p1ne/fdim-controller/doc/images/fdim_connector_stock.jpg

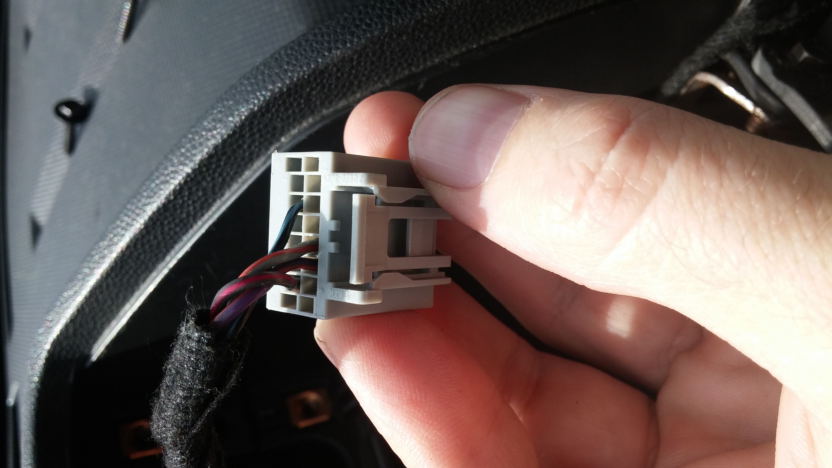
doc/images/fdim_connector_stock.jpg
