p1ne/fdim-controller/doc/images/fdim_rear.jpg

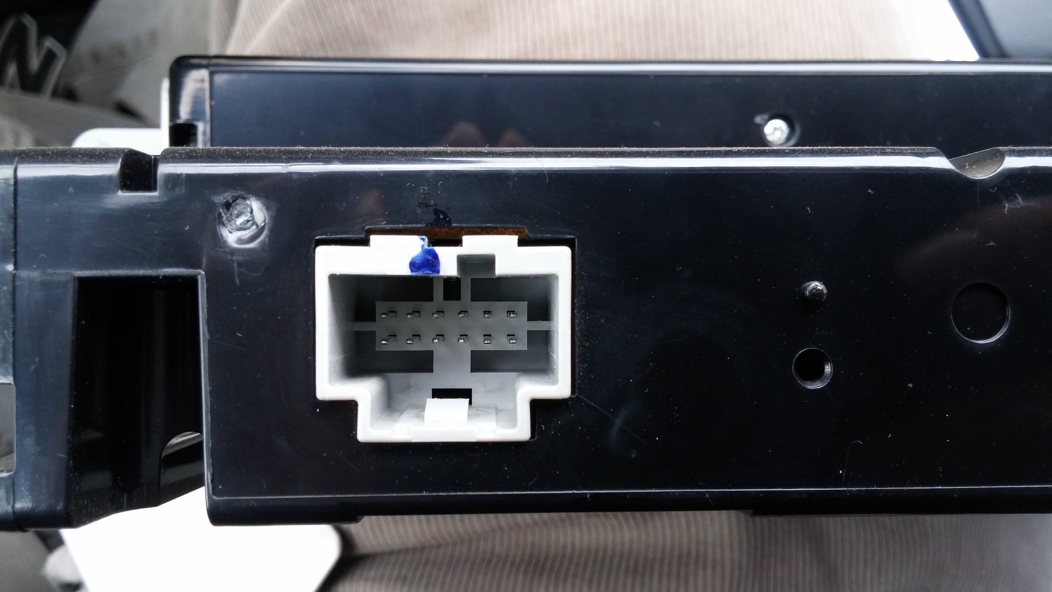
doc/images/fdim_rear.jpg
