p1ne/fdim-controller/doc/images/hu_aftermarket_can.jpg

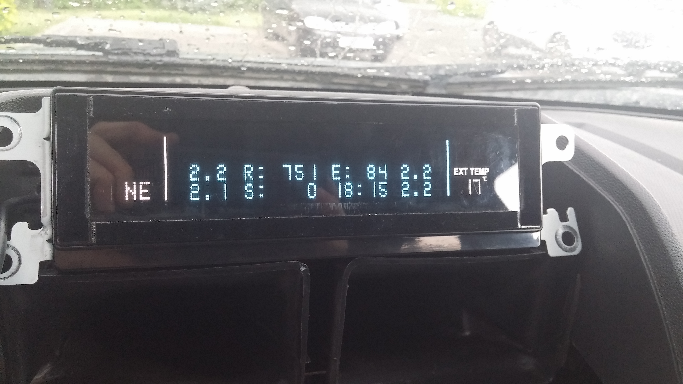
doc/images/hu_aftermarket_can.jpg
