p1ne/fdim-controller/doc/images/hu_minimal.jpg

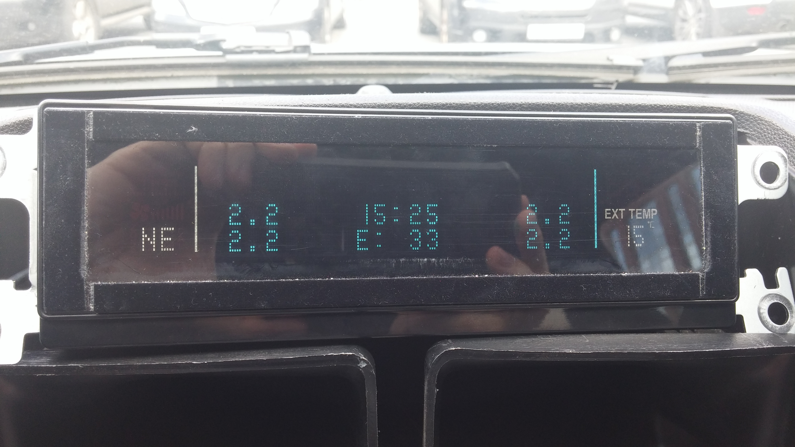
doc/images/hu_minimal.jpg
