p1ne/fdim-controller/doc/images/hu_stock.jpg

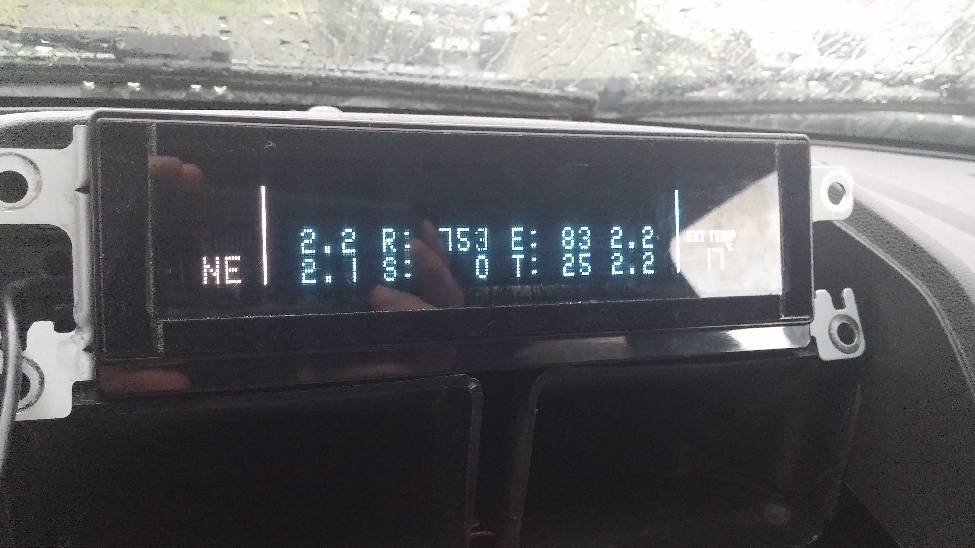
doc/images/hu_stock.jpg
