p1ne/fdim-controller/doc/images/module_elm.jpg

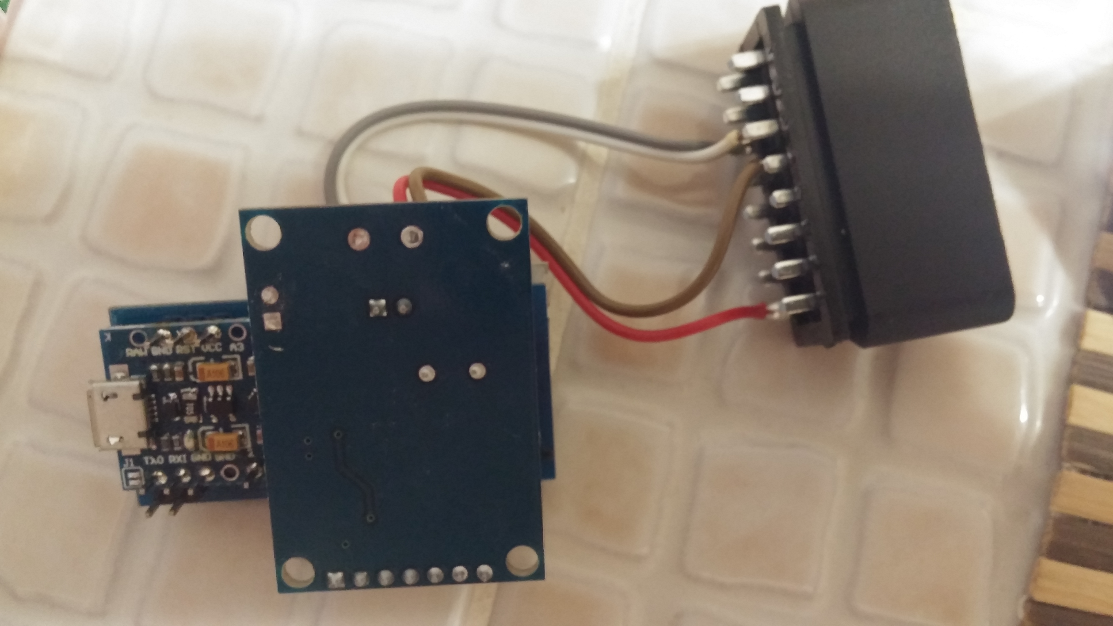
doc/images/module_elm.jpg
