p1ne/fdim-controller/doc/images/options_kpa.jpg

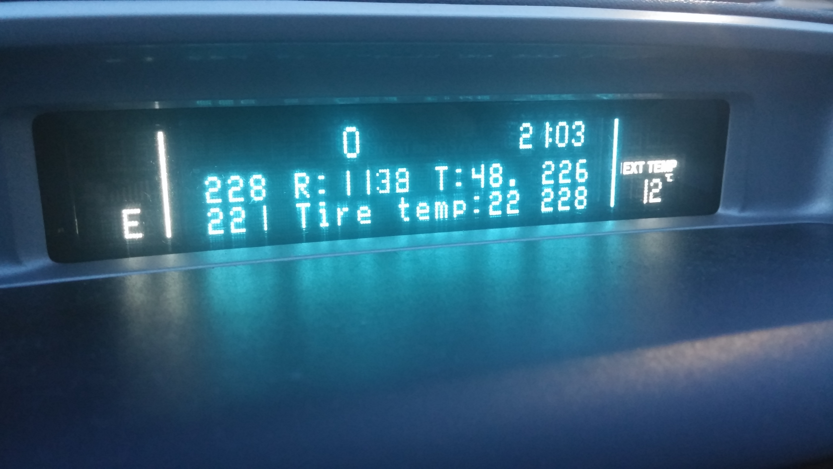
doc/images/options_kpa.jpg
