p1ne/fdim-controller/doc/images/rtc_replaced_battery.jpg

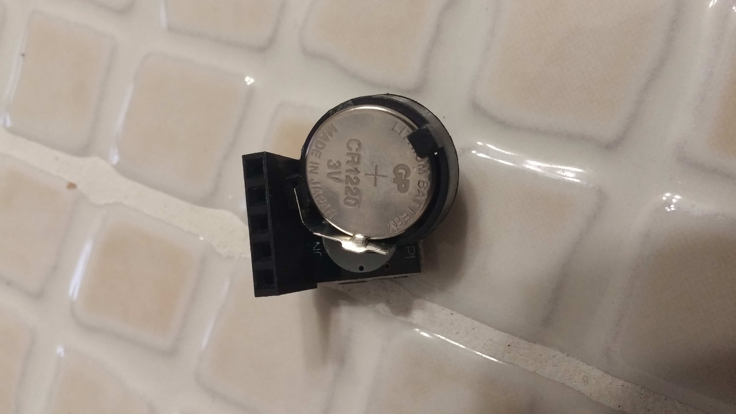
doc/images/rtc_replaced_battery.jpg
