p1ne/fdim-controller/doc/zadig/zadig6.png

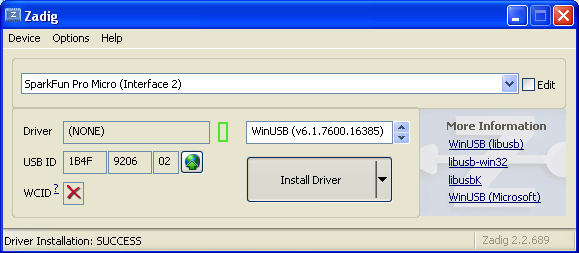
doc/zadig/zadig6.png
