p1ne/fdim-controller/doc/images/components/pin-strips-2x6.jpg

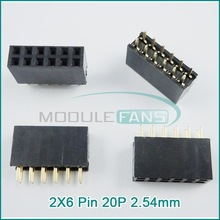
doc/images/components/pin-strips-2x6.jpg
