p1ne/fdim-controller/doc/images/fdim_connector_wiring.jpg

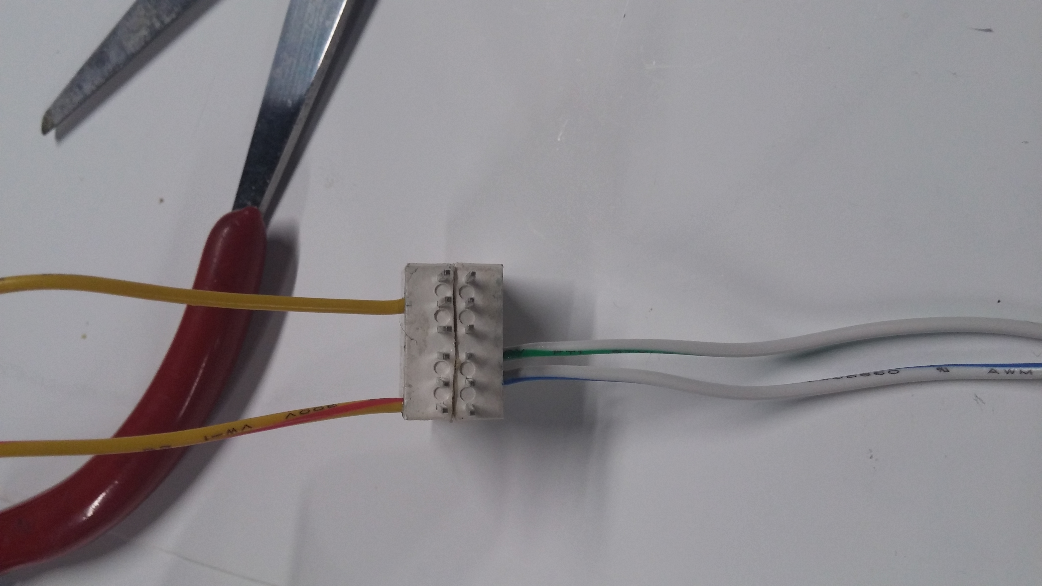
doc/images/fdim_connector_wiring.jpg
