p1ne/fdim-controller/doc/images/history_modules_generations.jpg

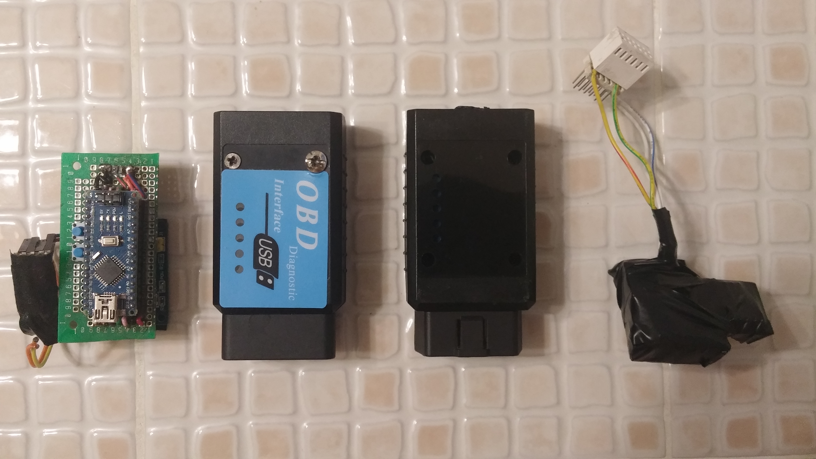
doc/images/history_modules_generations.jpg
