p1ne/fdim-controller/(threads)

Thread 2 (2019-04-27):

Clock 12 Hr setting issues

itbland, 2019-04-27:
When the clock is set to 12 Hr mode, there is one problem and one setting missing:

1. In 12 hr mode the % calculation results in a zero for the first hour and 12th hour of the day.
Possible solution: just after line 390, would an if statement something like:
`if (hour == 0  && currentSettings.clockMode == CLOCK_12)
    hour = 12;`
be the fix since it would be a problem for both the RTC and GPS in 12 Hr mode.
2. In 12 hr mode, the clock's flags data byte sent should be updated to 0xA0 for AM, 0xC0 for PM

Thread 6 (2019-07-09):

Utilize MS-CAN for homebrew AUX/DVD input

fuxxociety, 2019-07-09:
Im doing some research, and stumbled upon your code.

I have a 2004 & 2005 Ford, so no message center, just a dumb radio. I'd like to configure two AUX inputs on my radio. (I have the factory DVD player, it has RCA inputs on the front panel and both DVD & RCA inputs are unique "inputs".

It looks like message header 0x3e8 is the magic packet I would need.

Can you suggest a howto or primer I could reference to get this functionality for my arduino?

Sorry for the bug report, I could find no other contact method.

Thread 8 (2020-02-10):

Tire display order

bmwhitetx, 2020-02-10:
In the case statement for setting up the display, The HU_STOCK and two HU_CHINESE's both have the rear tire pressures listed as RL first and RR second which makes sense and matches the front tire order defined in preceding line.

However the HU_AFTERMARKET has the order reversed: RR is listed on the left and RL is on on the right. (lines removed for readablilty)

          case HU_AFTERMARKET:
            displayText(1, tirePressure[TIRE_FL].padRight(pressurePadding) + rpmMessage + rpm.padRight(4) + F(" E:") + temperature.padRight(3) + " " + tirePressure[TIRE_FR].padRight(pressurePadding));
            displayText(2, tirePressure[TIRE_RR].padRight(pressurePadding) + tireTempMessage + tireTemperature.padRight(3) + " " + tirePressure[TIRE_RL].padRight(pressurePadding));

          case HU_STOCK:
            displayText(1, tirePressure[TIRE_FL].padRight(pressurePadding) + rpmMessage + rpm.padRight(4) + F(" E:") + temperature.padRight(3) + " " + tirePressure[TIRE_FR].padRight(pressurePadding));
            displayText(2, tirePressure[TIRE_RL].padRight(pressurePadding) + spdMessage + carSpeed.padRight(4) + F(" T:") + tireTemperature.padRight(3) + " " + tirePressure[TIRE_RR].padRight(pressurePadding));

          case HU_CHINESE_WITH_CAN_SIMPLE:
            displayText(1, tirePressure[TIRE_FL].padRight(pressurePadding) + clockMessage.padCenter(textMsgLength+2) + tirePressure[TIRE_FR].padRight(pressurePadding));
            displayText(2, tirePressure[TIRE_RL].padRight(pressurePadding) + temperatureMessage.padCenter(textMsgLength+2) + tirePressure[TIRE_RR].padRight(pressurePadding));

          case HU_CHINESE_WITH_CAN_EXTENDED:
            displayText(1, tirePressure[TIRE_FL].padRight(pressurePadding) + rpmMessage + rpm.padRight(4) + F(" E:") + temperature.padRight(3) + " " + tirePressure[TIRE_FR].padRight(pressurePadding));
            displayText(2, tirePressure[TIRE_RL].padRight(pressurePadding) + spdMessage + carSpeed.padRight(4) + F(" ") + clockMessage + F(" ") + tirePressure[TIRE_RR].padRight(pressurePadding));

Great work BTW, Just what I was looking for!
