p1ne/fdim-controller/(list of files, drawings)

Other design files:
pcb/diptrace/can-clock-17-09.dch
pcb/diptrace/can-clock-17-09.dip
