p1ne/fdim-controller/(commit log)

2016-01-30 Fixed delays in text CAN messages set
    [can-clock.ino]
2016-03-20 Numerous fixes, clean-up of timing constants
    [can-clock.ino]
2016-05-31 Turn off display (partly broken)
    [can-clock.ino]
2016-06-01 Massive refactor of message sending - bound to common timer now
2017-02-13 Moved CANMessage class to separate file Modified libraries search path in platformio.ini Added compile-time defines to properly set interrupts on 328/32u4 boards Datatypes cleanup (signed/unsigned, b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
2017-02-14 Experimental refactoring: moved all strings that need fomatting to FormattedString class Made cleanup of datatypes, cleanup for CANMessage::print() function
2017-02-14 Massively fix FormattedString.h to work properly
    [FormattedString.h, can-clock.ino]
2017-04-21 temp update for int pin number
2017-04-21 changed pin mode
2017-04-21 updated interrupt pin number for Nano
2017-04-21 Updated interrupt pin number for Arduino Pro Micro
2017-06-15 Added preliminary RTC support for pre-2010 vehicles. Separated CAN sequences to FordMessages.h Added defines to prevent multi-inclusion of *.h files
    [CANMessage.h, FordMessages.h, FormattedString.h, can-clock.ino]
2017-06-15 Added missing change for one-time settings run (see previous commit)
    [Settings.h]
2017-06-15 add wiring connections instruction
2017-06-15 Modified interrupt pin number for Nano
2017-06-15 Reverted back lost changes from experimental
    [can-clock.ino]
2017-06-15 Moved to forked CAN library with setting of CAN mode Updated code for proper setting of filters and masks Misc improvements and bug fixes
    [Settings.h, can-clock.ino]
2017-06-15 Added temperature rounding
2017-06-15 Added support for TPMS request-response protocol No support for tire temperature yet
2017-06-15 Moved pressure strings initialization to another place
2017-06-15 Modified way to parse pressure responses 0x72e
2017-06-15 if condition typo fix
    [can-clock.ino]
2017-06-15 Fixed TPMS fields indexes
    [can-clock.ino]
2017-06-15 Changed bars to kPa to display pressure
2017-06-15 Added tire temperature to requests loop
2017-06-15 Removed IS_HYBRID workaround, changed to 0x423 5th byte analysis Fixed typos in settings menu
    [Settings.h, can-clock.ino]
2017-06-15 Modified car start/stop condition Tweaked type conversion for temperature, RPM and speed
2017-06-15 Made TPMS requests less frequent Added CAN interrupt attach/detach for Initialization Modified variables visibility Added sentOnTick check for all sends (if message is already sent on this tick, incr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
2017-06-21 fixed problem with -40 tires temperature
    [can-clock.ino]
2017-06-21 Added tristate selection of tires pressure units: Psi, Bars, kPa
2017-06-22 Added separate function to calculate pressure string, fixed calculation
    [Settings.h, can-clock.ino]
2017-06-27 Print tires temp message only if TPMS settings are relevant
2017-07-06 Fixed issues with cycle messages on aftermarket HU Made memory optimizations (500 bytes left for code)
    [FordMessages.h, Service.h, Settings.h, can-clock.ino]
2017-07-12 Add readme and DipTrace schematics
    [can-clock-4.dch, can-clock-4.dip]
2017-07-12 Added images for readme, moved wiring.txt
2017-07-19 Added Gerber files ready to order at DirtCheap PCB
    [Bottom.GBL, BottomMask.GBS, BottomSilk.GBO, Through.drl, Top.GTL, TopMask.GTS, TopSilk.GTO]
2017-07-19 Added new mount type and updated readme
2017-07-19 Added voltage regulator picture and parts list Added more CAN messages description
2017-09-05 Fixed PCB (forgot to wire GND to RTC)
    [can-clock-17-09.dch, can-clock-17-09.dip, can-clock-4.dip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]
2017-09-05 Added images for step by step soldering process
2017-09-05 Added links of soldering images to README
2017-09-05 Rotated PCB image, added step-by-step descriptions for soldering
2017-09-07 Added donate button
2017-10-05 Preliminary support for ESP32 added
2017-10-26 Winter is coming. Changed temperature to be signed instead of unsigned
2018-03-27 Removed esp32 support
2018-03-27 Only Arduino Pro Micro support left. No plans for other base hardware
2019-04-18 Tweaked Wire initialization to properly handle RTC
2019-04-27 added reading of current time
2019-04-29 added saving settings. still buggy
    [Settings.h, can-clock.ino]
2019-05-31 (almost) fixed comm protocol
    [CANMessage.h, Settings.h, can-clock.ino]
2019-07-30 fixed temperature rounding for F
    [can-clock.ino]
2019-08-01 tire pressure fixes
2019-12-12 rolled back some wrong changes with typing and tire requests
    [can-clock.ino]
2019-12-24 Tires order iteration change
